travisgoodspeed/goodwatch/hardware/goodpocketwatch31/goodpocketwatch31.kicad_pcb

## KiCad design hardware/goodpocketwatch31/goodpocketwatch31.kicad_pcb (2022-01-03)

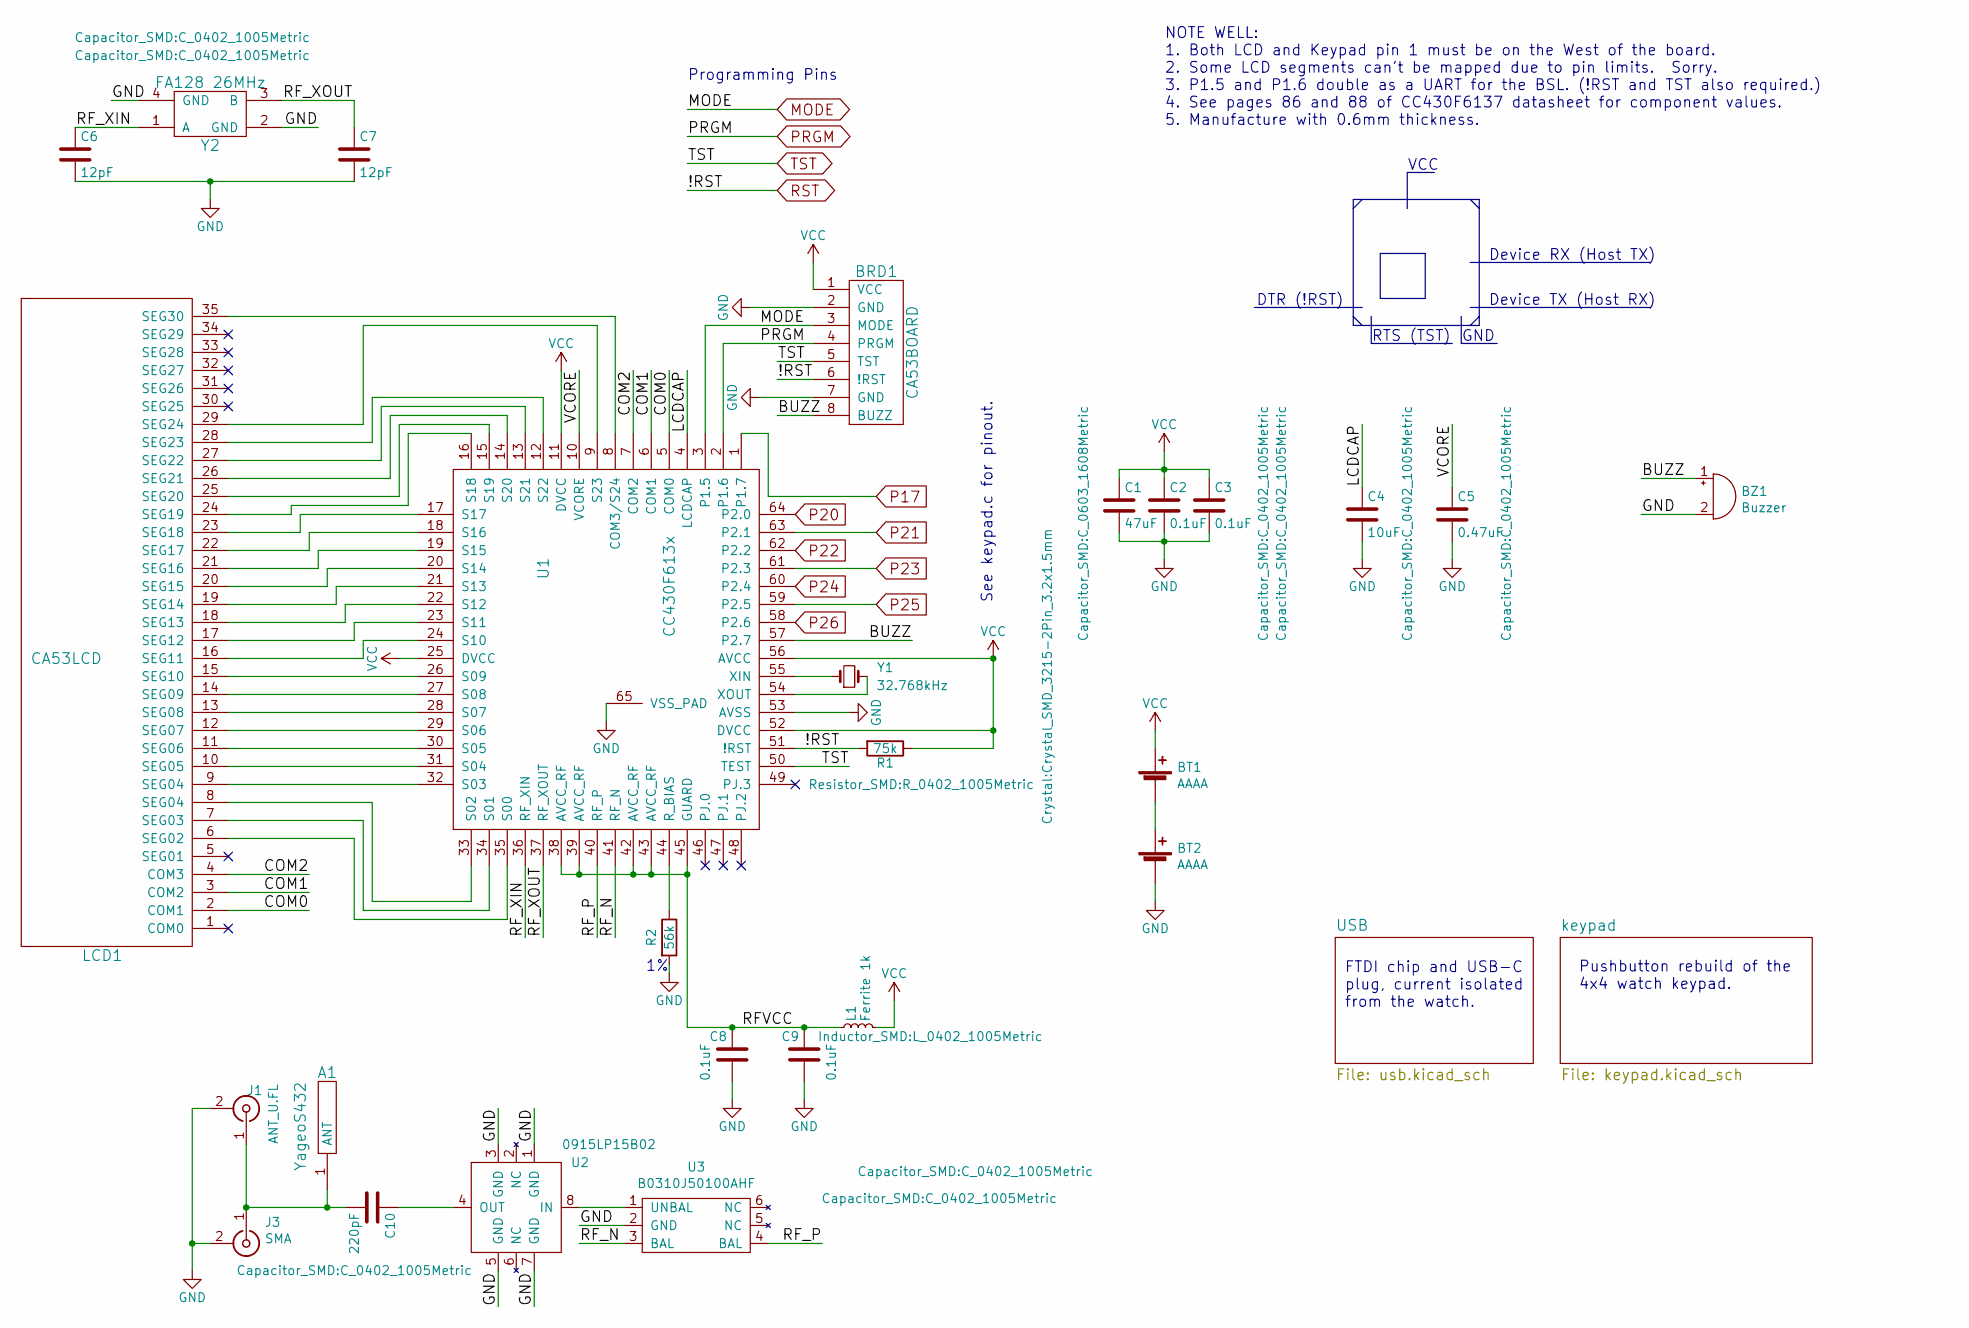
[picture p1: schematic goodpocketwatch31.kicad_sch, GoodPocketWatch]

Parts:
A1: YageoS432
BRD1: CA53BOARD; ca53board
BT1, BT2: AAAA; BE-AAAA-PC
BZ1: Buzzer; PT-1203-3
C1: 47uF; C_0603_1608Metric
C2, C3, C8, C9: 0.1uF; C_0402_1005Metric
C4: 10uF; C_0402_1005Metric
C5: 0.47uF; C_0402_1005Metric
C6, C7: 12pF; C_0402_1005Metric
C10: 220pF; C_0402_1005Metric
J1: ANT_U.FL; U.FL_Molex_MCRF_73412-0110_Vertical
J3: SMA; SMA_Amphenol_132289_EdgeMount
L1: Ferrite 1k; L_0402_1005Metric
LCD1: CA53LCD; ca53lcd
R1: 75k; R_0402_1005Metric
R2: 56k; R_0402_1005Metric
U1: CC430F613x
U2: 0915LP15B02; LP15
U3: B0310J50100AHF
Y1: 32.768kHz; Crystal_SMD_3215-2Pin_3.2x1.5mm
Y2: FA128 26MHz; FA128

Connections:
/BUZZ: BRD1.8 (BUZZ), BZ1.1 (-), U1.57 (P2.7)
/COM0: LCD1.2 (COM1), U1.5 (COM0)
/COM1: LCD1.3 (COM2), U1.6 (COM1)
/COM2: LCD1.4 (COM3), U1.7 (COM2)
/LCDCAP: C4.1, U1.4 (LCDCAP)
/RFVCC: C8.1, C9.1, L1.1, U1.38 (AVCC_RF), U1.39 (AVCC_RF), U1.42 (AVCC_RF), U1.43 (AVCC_RF), U1.45 (GUARD)
/RF_N: U1.41 (RF_N), U3.3 (BAL)
/RF_P: U1.40 (RF_P), U3.4 (BAL)
/RF_XIN: C6.1, U1.36 (RF_XIN), Y2.1 (A)
/RF_XOUT: C7.1, U1.37 (RF_XOUT), Y2.3 (B)
/VCORE: C5.1, U1.10 (VCORE)
GND: BRD1.2 (GND), BRD1.7 (GND), BT2.2 (-), BZ1.2 (+), C1.2, C2.2, C3.2, C4.2, C5.2, C6.2, C7.2, C8.2, C9.2, J1.2 (Ext), J3.2 (Ext), R2.2, U1.53 (AVSS), U1.65 (VSS_PAD), U2.1 (GND), U2.3 (GND), U2.5 (GND), U2.7 (GND), U3.2 (GND), Y2.2 (GND), Y2.4 (GND); also elsewhere on the board
MODE: BRD1.3 (MODE), U1.3 (P1.5); also elsewhere on the board
unnamed: A1.1, C10.2, J1.1 (In), J3.1 (In)
unnamed: BT1.2 (-), BT2.1 (+)
unnamed: C10.1, U2.4 (OUT)
unnamed: LCD1.6 (SEG02), U1.35 (S00)
unnamed: LCD1.7 (SEG03), U1.34 (S01)
unnamed: LCD1.8 (SEG04), U1.33 (S02)
unnamed: LCD1.9 (SEG04), U1.32 (S03)
unnamed: LCD1.10 (SEG05), U1.31 (S04)
unnamed: LCD1.11 (SEG06), U1.30 (S05)
unnamed: LCD1.12 (SEG07), U1.29 (S06)
unnamed: LCD1.13 (SEG08), U1.28 (S07)
unnamed: LCD1.14 (SEG09), U1.27 (S08)
unnamed: LCD1.15 (SEG10), U1.26 (S09)
unnamed: LCD1.16 (SEG11), U1.24 (S10)
unnamed: LCD1.17 (SEG12), U1.23 (S11)
unnamed: LCD1.18 (SEG13), U1.22 (S12)
unnamed: LCD1.19 (SEG14), U1.21 (S13)
unnamed: LCD1.20 (SEG15), U1.20 (S14)
unnamed: LCD1.21 (SEG16), U1.19 (S15)
unnamed: LCD1.22 (SEG17), U1.18 (S16)
unnamed: LCD1.23 (SEG18), U1.17 (S17)
unnamed: LCD1.24 (SEG19), U1.16 (S18)
unnamed: LCD1.25 (SEG20), U1.15 (S19)
unnamed: LCD1.26 (SEG21), U1.14 (S20)
unnamed: LCD1.27 (SEG22), U1.13 (S21)
unnamed: LCD1.28 (SEG23), U1.12 (S22)
unnamed: LCD1.29 (SEG24), U1.9 (S23)
unnamed: LCD1.35 (SEG30), U1.8 (COM3/S24)
unnamed: R2.1, U1.44 (R_BIAS)
unnamed: U1.54 (XOUT), Y1.2
unnamed: U1.55 (XIN), Y1.1
unnamed: U2.8 (IN), U3.1 (UNBAL)
P17: U1.1 (P1.7); also elsewhere on the board
P20: U1.64 (P2.0); also elsewhere on the board
P21: U1.63 (P2.1); also elsewhere on the board
P22: U1.62 (P2.2); also elsewhere on the board
P23: U1.61 (P2.3); also elsewhere on the board
P24: U1.60 (P2.4); also elsewhere on the board
P25: U1.59 (P2.5); also elsewhere on the board
P26: U1.58 (P2.6); also elsewhere on the board
PRGM: BRD1.4 (PRGM), U1.2 (P1.6); also elsewhere on the board
RST: BRD1.6 (!RST), R1.2, U1.51 (!RST); also elsewhere on the board
TST: BRD1.5 (TST), U1.50 (TEST); also elsewhere on the board
VCC: BRD1.1 (VCC), BT1.1 (+), C1.1, C2.1, C3.1, L1.2, R1.1, U1.11 (DVCC), U1.25 (DVCC), U1.52 (DVCC), U1.56 (AVCC); also elsewhere on the board

Notes on the sheet:
RTS (TST)
See keypad.c for pinout.
NOTE WELL: 1. Both LCD and Keypad pin 1 must be on the West of the board. 2. Some LCD segments can't be mapped due to pin limits. Sorry. 3. P1.5 and P1.6 double as a UART for the BSL. (!RST and TST also required.) 4. See pages 86 and 88 of CC430F6137 datasheet for component values. 5. Manufacture w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
VCC
Device TX (Host RX)
Programming Pins
DTR (!RST)
Pushbutton rebuild of the 4x4 watch keypad.
GND
Device RX (Host TX)
FTDI chip and USB-C plug, current isolated from the watch.

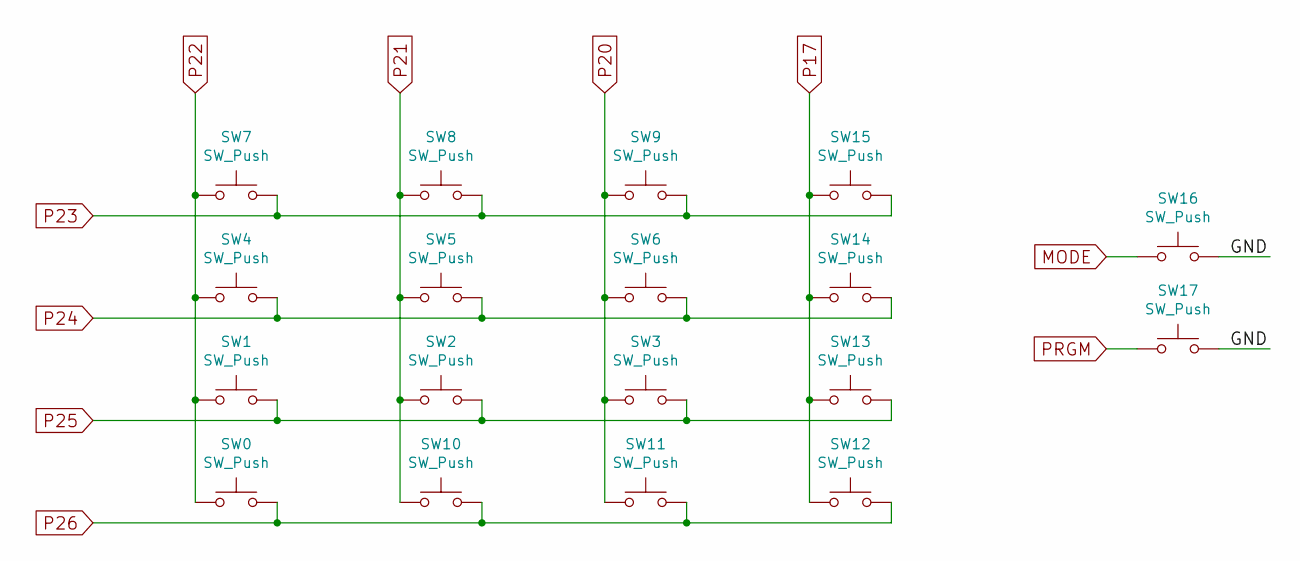
[picture p2: schematic keypad.kicad_sch, GPW Keypad]

Parts:
SW0, SW1, SW2, SW3, SW4, SW5, SW6, SW7, SW8, SW9, SW10, SW11, SW12, SW13, SW14, SW15, SW16, SW17: SW_Push; TL6700

Connections:
GND: SW16.2, SW17.2; also elsewhere on the board
MODE: SW16.1; also elsewhere on the board
P17: SW12.1, SW13.1, SW14.1, SW15.1; also elsewhere on the board
P20: SW3.1, SW6.1, SW9.1, SW11.1; also elsewhere on the board
P21: SW2.1, SW5.1, SW8.1, SW10.1; also elsewhere on the board
P22: SW0.1, SW1.1, SW4.1, SW7.1; also elsewhere on the board
P23: SW7.2, SW8.2, SW9.2, SW15.2; also elsewhere on the board
P24: SW4.2, SW5.2, SW6.2, SW14.2; also elsewhere on the board
P25: SW1.2, SW2.2, SW3.2, SW13.2; also elsewhere on the board
P26: SW0.2, SW10.2, SW11.2, SW12.2; also elsewhere on the board
PRGM: SW17.1; also elsewhere on the board

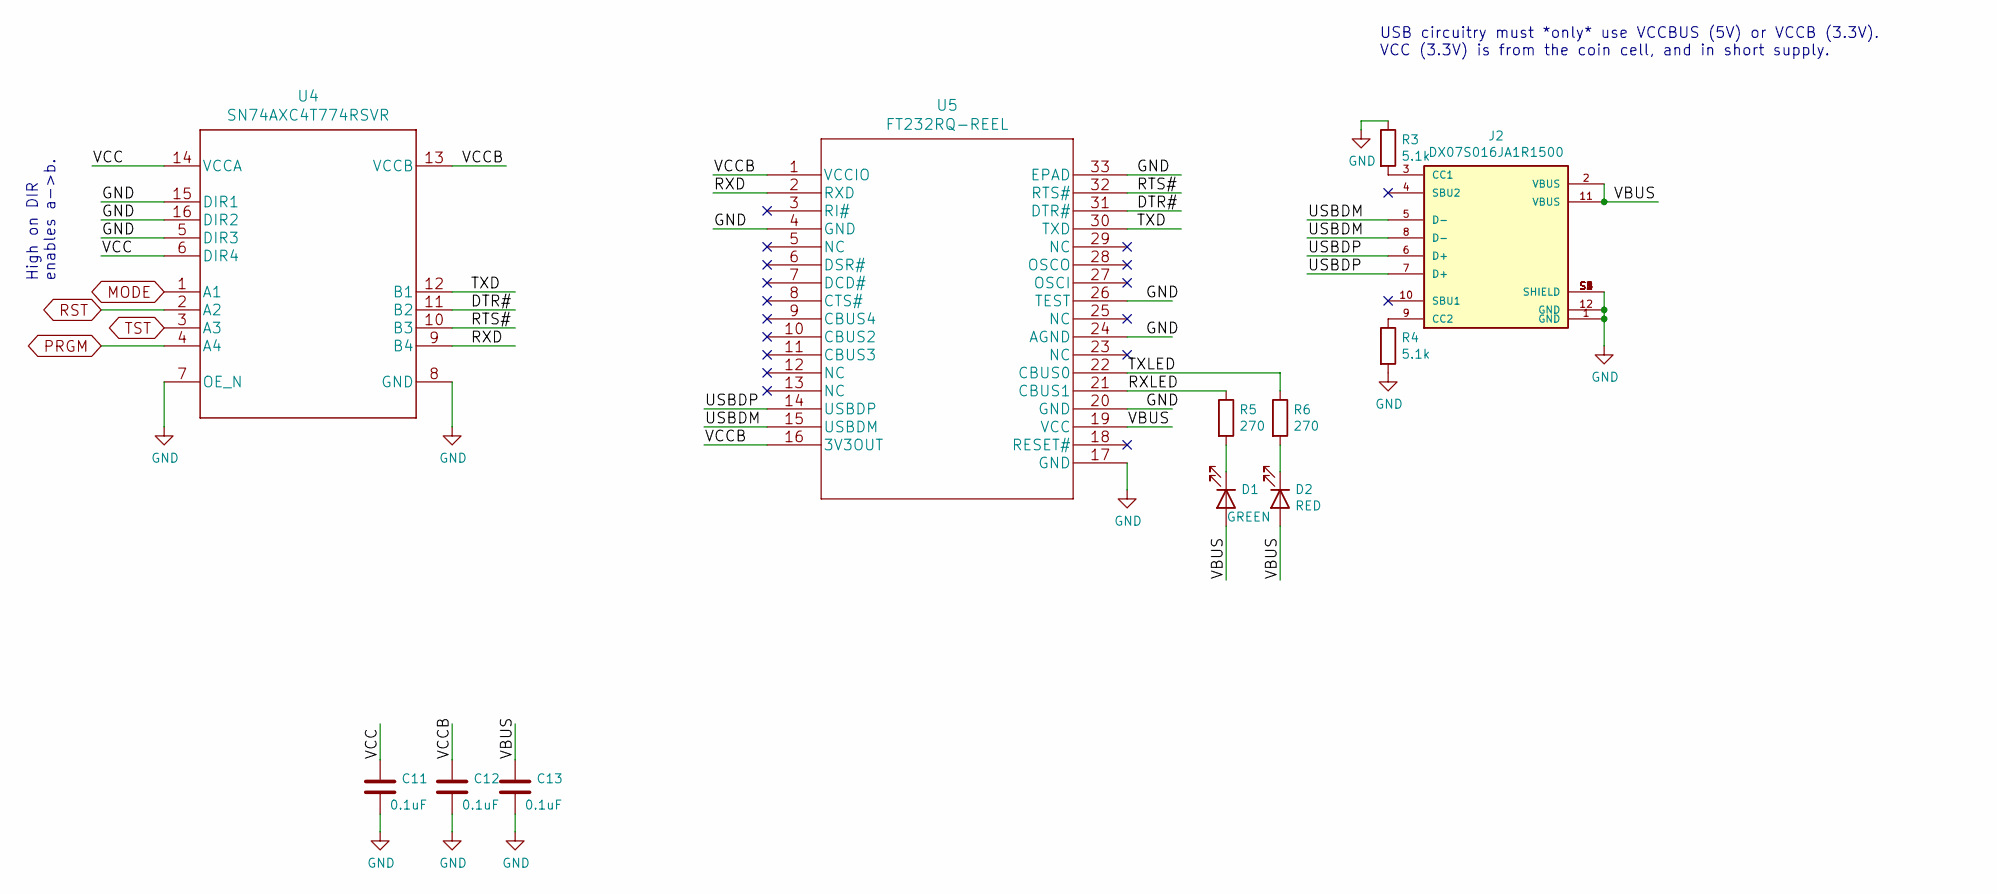
[picture p3: schematic usb.kicad_sch, USB Programmer for GW31]

Parts:
C11, C12, C13: 0.1uF; C_0402_1005Metric
D1: GREEN; R_0402_1005Metric
D2: RED; R_0402_1005Metric
J2: DX07S016JA1R1500; JAE_DX07S016JA1R1500; PARTREV 1
R3, R4: 5.1k; R_0402_1005Metric
R5, R6: 270; R_0402_1005Metric
U4: SN74AXC4T774RSVR
U5: FT232RQ-REEL

Connections:
/USB/DTR#: U4.11 (B2), U5.31 (DTR#)
/USB/RTS#: U4.10 (B3), U5.32 (RTS#)
/USB/RXD: U4.9 (B4), U5.2 (RXD)
/USB/RXLED: R5.1, U5.21 (CBUS1)
/USB/TXD: U4.12 (B1), U5.30 (TXD)
/USB/TXLED: R6.1, U5.22 (CBUS0)
/USB/USBDM: J2.5 (D-), J2.8 (D-), U5.15 (USBDM)
/USB/USBDP: J2.6 (D+), J2.7 (D+), U5.14 (USBDP)
/USB/VBUS: C13.1, D1.2 (A), D2.2 (A), J2.2 (VBUS), J2.11 (VBUS), U5.19 (VCC)
/USB/VCCB: C12.1, U4.13 (VCCB), U5.1 (VCCIO), U5.16 (3V3OUT)
GND: C11.2, C12.2, C13.2, J2.1 (GND), J2.12 (GND), J2.S1 (SHIELD), J2.S2 (SHIELD), J2.S3 (SHIELD), J2.S4 (SHIELD), J2.S5 (SHIELD), J2.S6 (SHIELD), R3.1, R4.2, U4.5 (DIR3), U4.7 (OE_N), U4.8 (GND), U4.15 (DIR1), U4.16 (DIR2), U5.4 (GND), U5.17 (GND), U5.20 (GND), U5.24 (AGND), U5.26 (TEST), U5.33 (EPAD); also elsewhere on the board
MODE: U4.1 (A1); also elsewhere on the board
unnamed: D1.1 (K), R5.2
unnamed: D2.1 (K), R6.2
unnamed: J2.3 (CC1), R3.2
unnamed: J2.9 (CC2), R4.1
PRGM: U4.4 (A4); also elsewhere on the board
RST: U4.2 (A2); also elsewhere on the board
TST: U4.3 (A3); also elsewhere on the board
VCC: C11.1, U4.6 (DIR4), U4.14 (VCCA); also elsewhere on the board

Notes on the sheet:
USB circuitry must *only* use VCCBUS (5V) or VCCB (3.3V). VCC (3.3V) is from the coin cell, and in short supply.
High on DIR enables a->b.

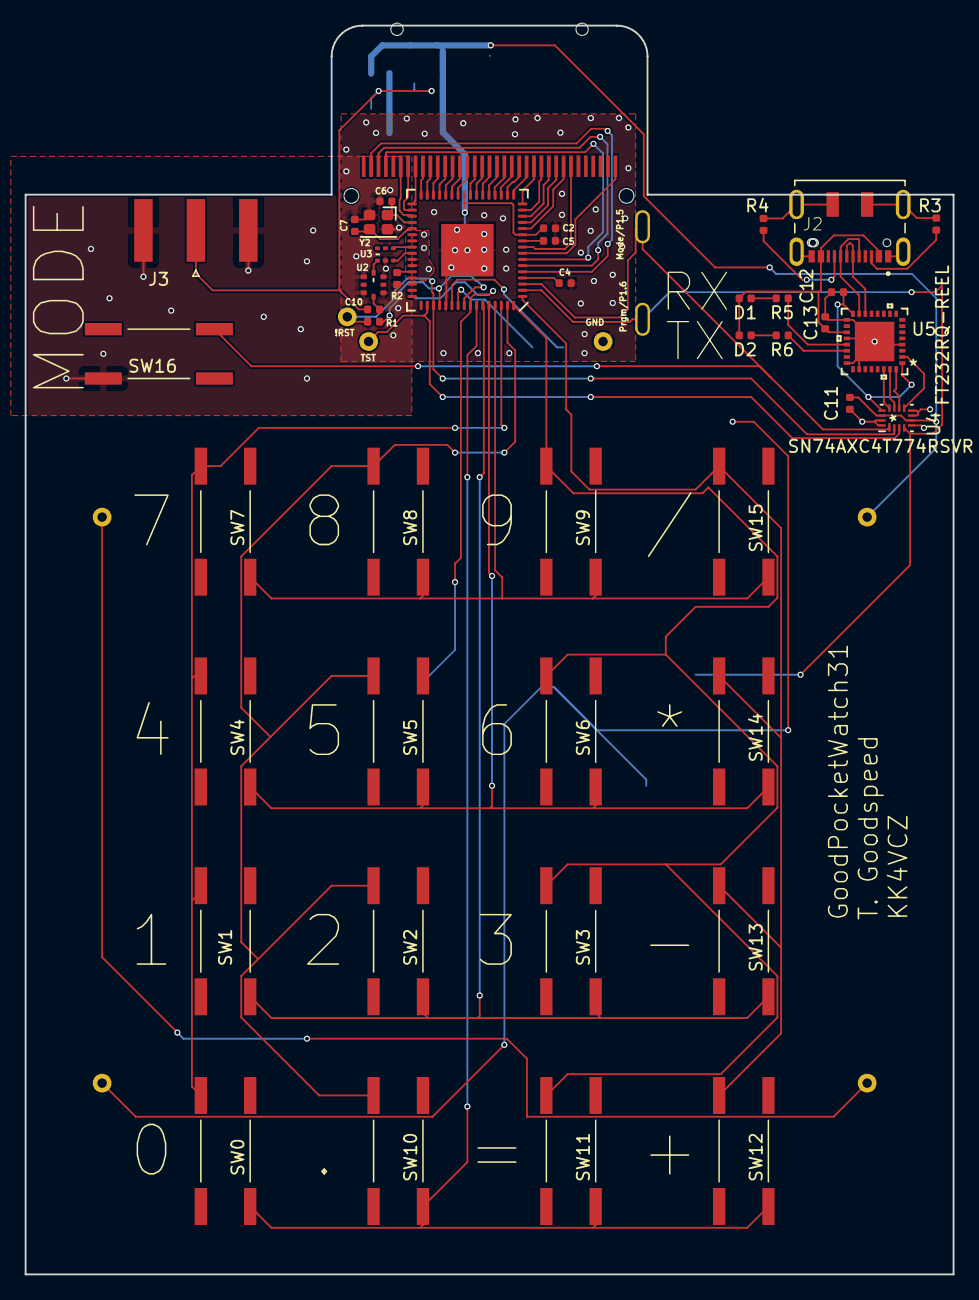
[picture p4: board goodpocketwatch31.kicad_pcb from above]

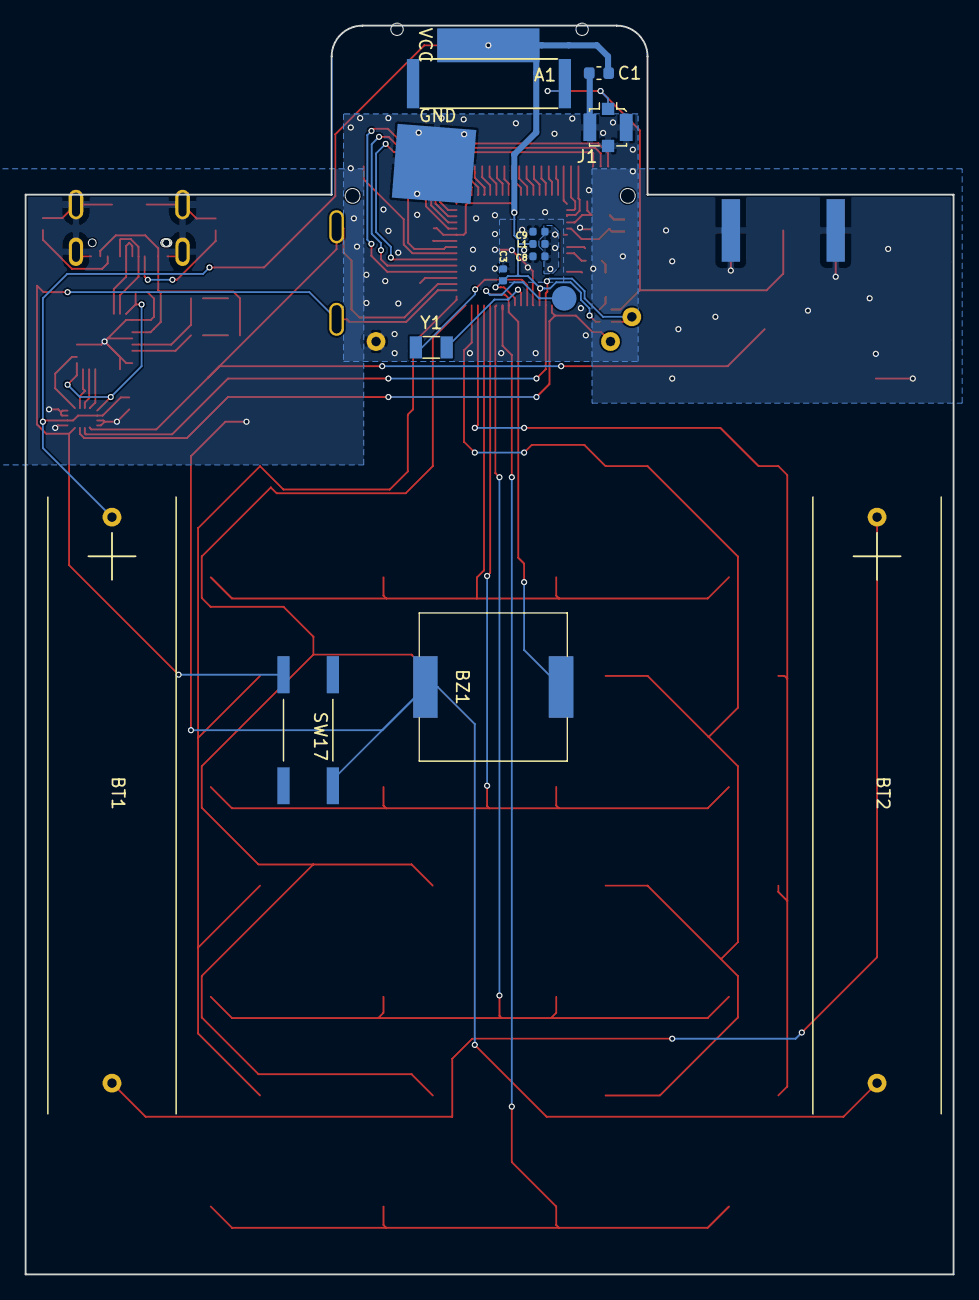
[picture p5: board goodpocketwatch31.kicad_pcb from below]

Board: 2 copper layers, 75.2 x 101.2 mm, 56 parts (12 on the bottom side), 71 nets.
